WarmT/BLDC-controller/README.md

# BLDC-controller
BLDC controller based on STSPIN32F0

Finished PCBs:
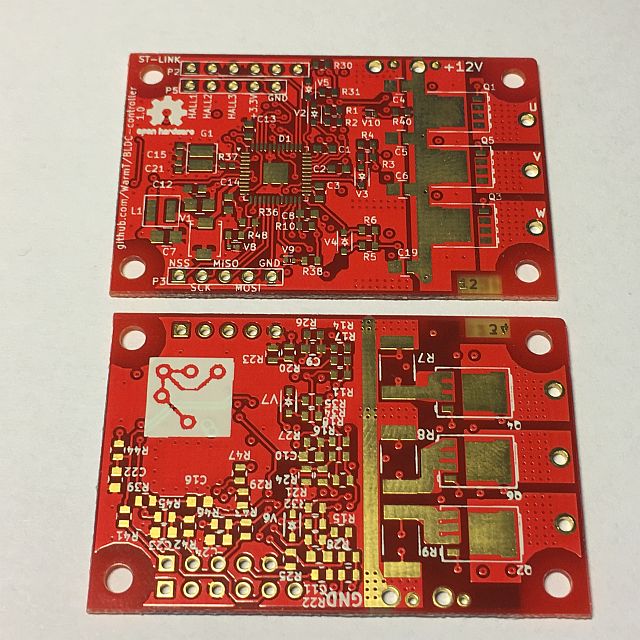
[picture p1: BLDC_controller_PCBs.jpg]
Top
