WarmT/BLDC-controller/PCB_bottom.png

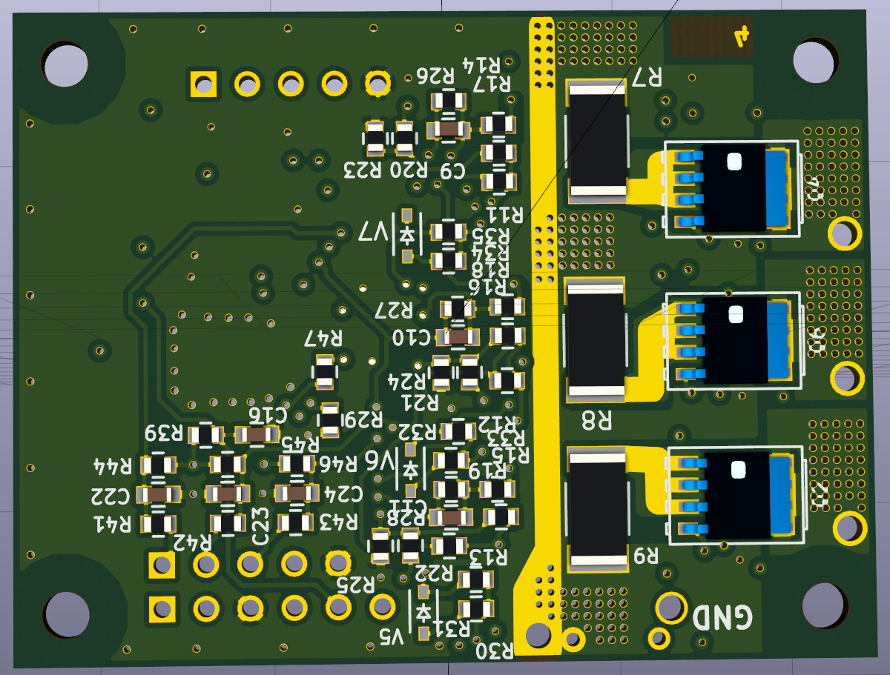
PCB_bottom.png
