WarmT/BLDC-controller/PCB_top.png

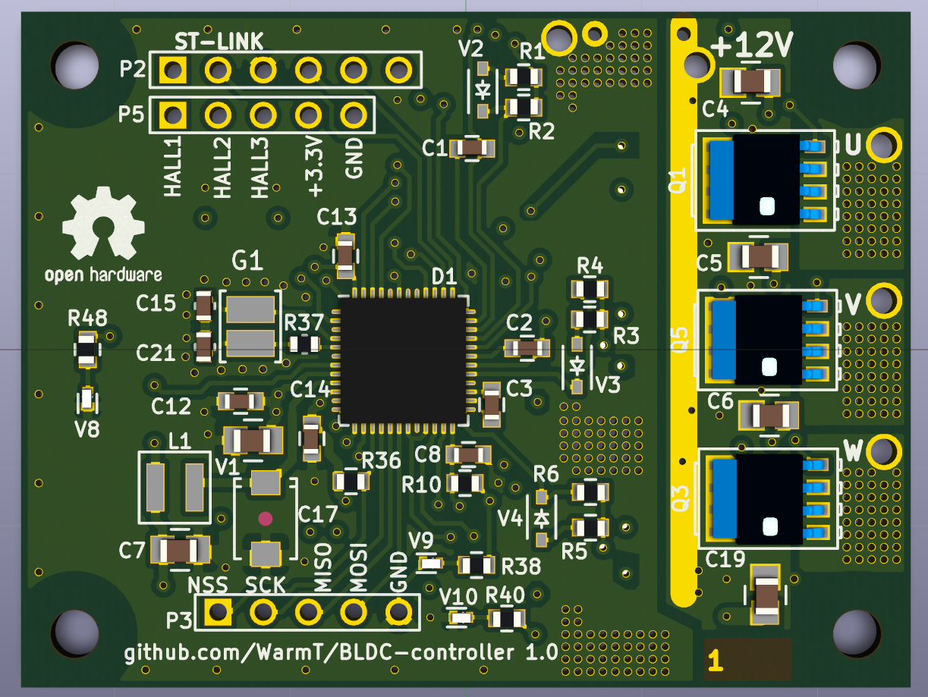
PCB_top.png
