WarmT/BLDC-controller/BLDC_controller.pdf

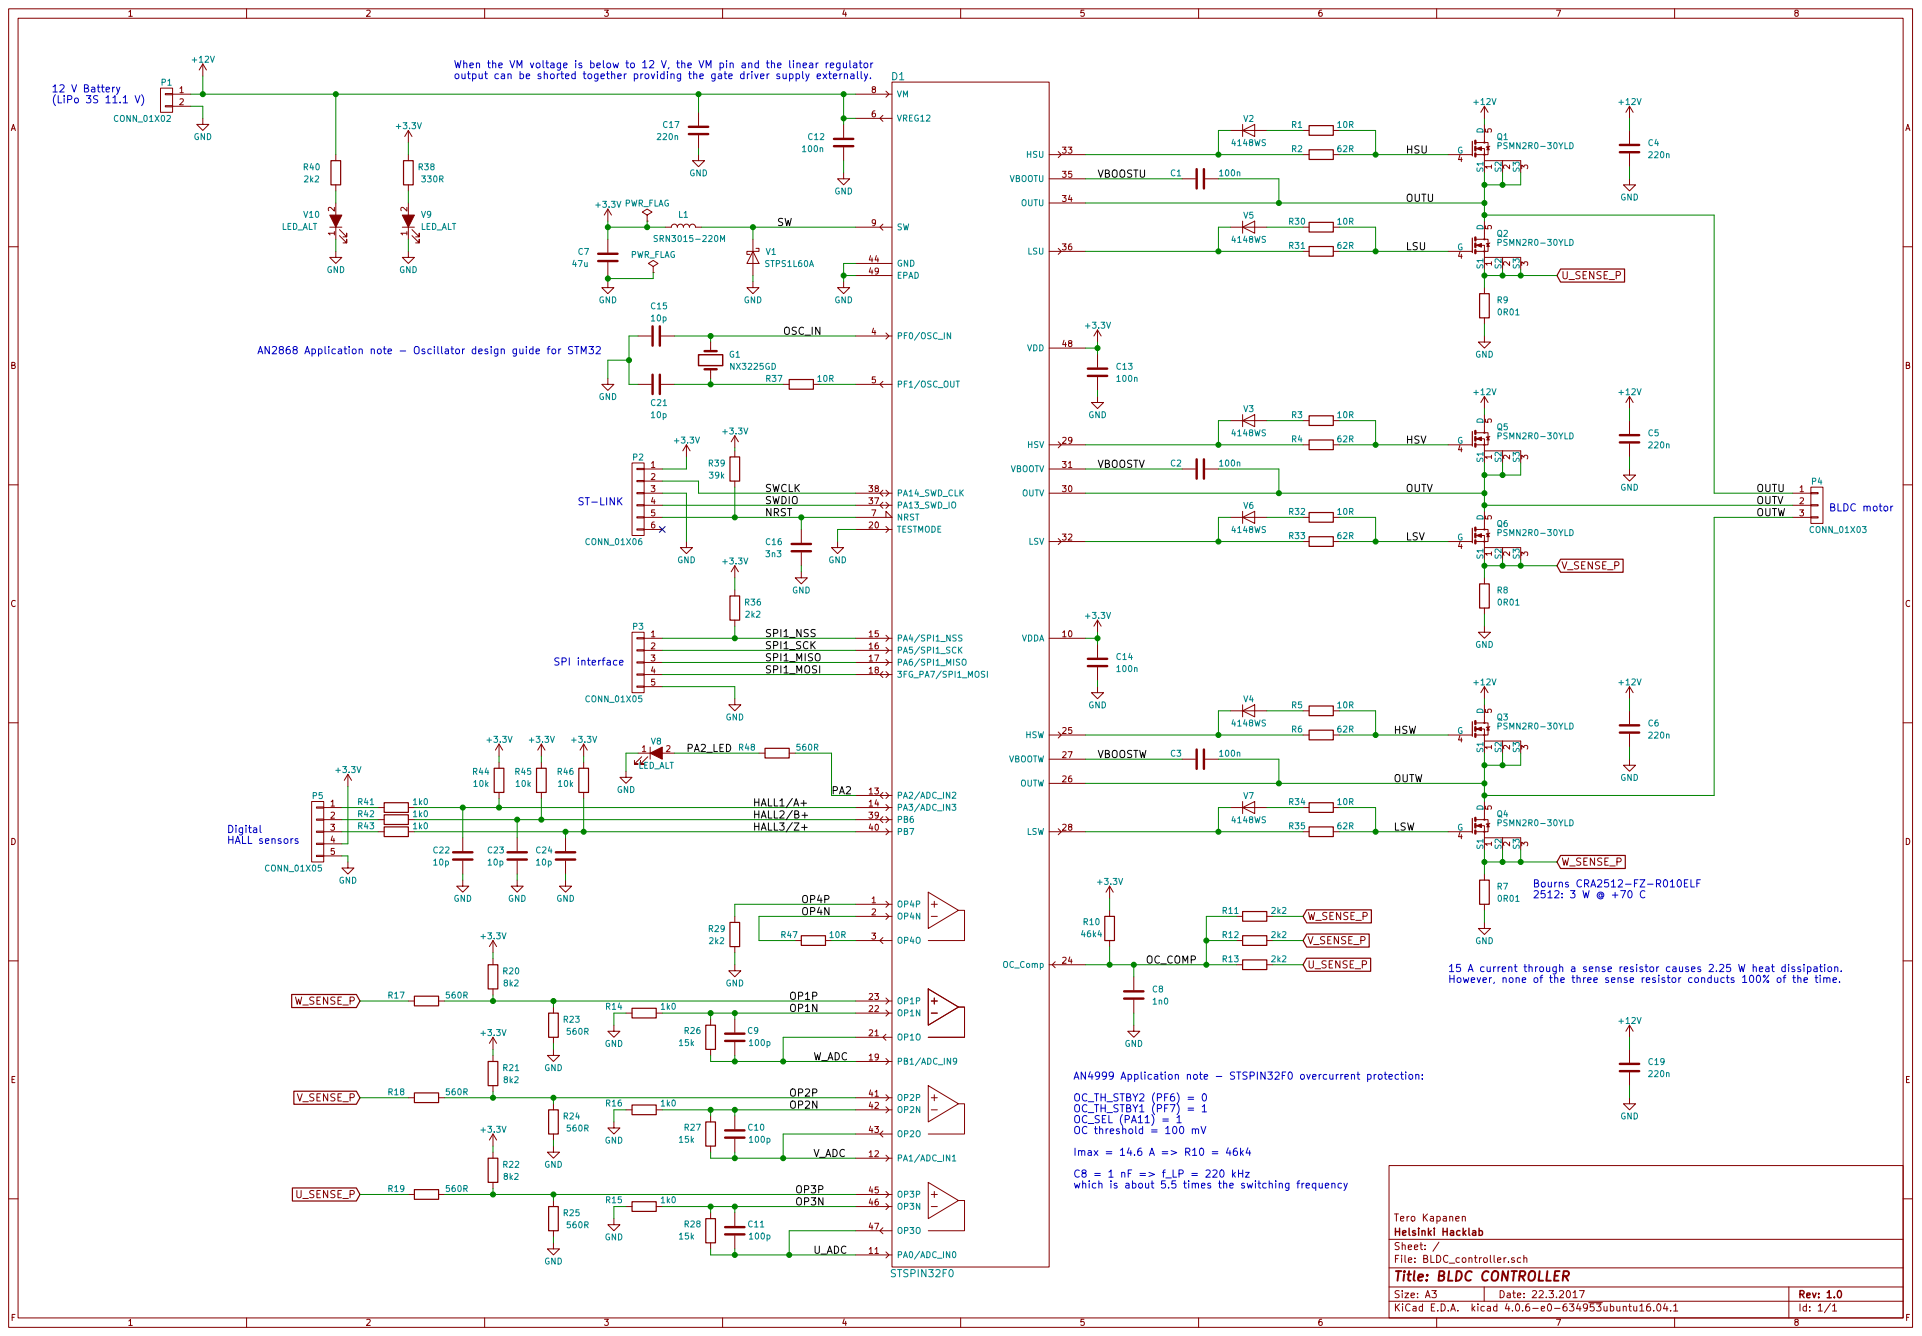
[picture p4: page 1]

PWR_FLAG When the VM voltage is below to 12 V, the VM pin and the linear regulator
output can be shorted together providing the gate driver supply externally.

PF0/OSC_IN 4 PF1/OSC_OUT 5 VREG12 6 NRST 7

AN2868 Application note - Oscillator design guide for STM32

4 | SWDIO
5 | NRST

2 SPI1_SCK
3 SPI1_MISO
4 | 3FG_PA7/SPI1_MOSI 18

15 A current through a sense resistor causes 2.25 W heat dissipation.
However, none of the three sense resistor conducts 100% of the time.

which is about 5.5 times the switching frequency

File: BLDC_controller.sch Sheet: / Helsinki Hacklab

Id: 1/1 Title: BLDC CONTROLLER
