WarmT/BLDC-controller/BLDC_controller.sch

## KiCad design BLDC_controller.sch (2017-03-22)

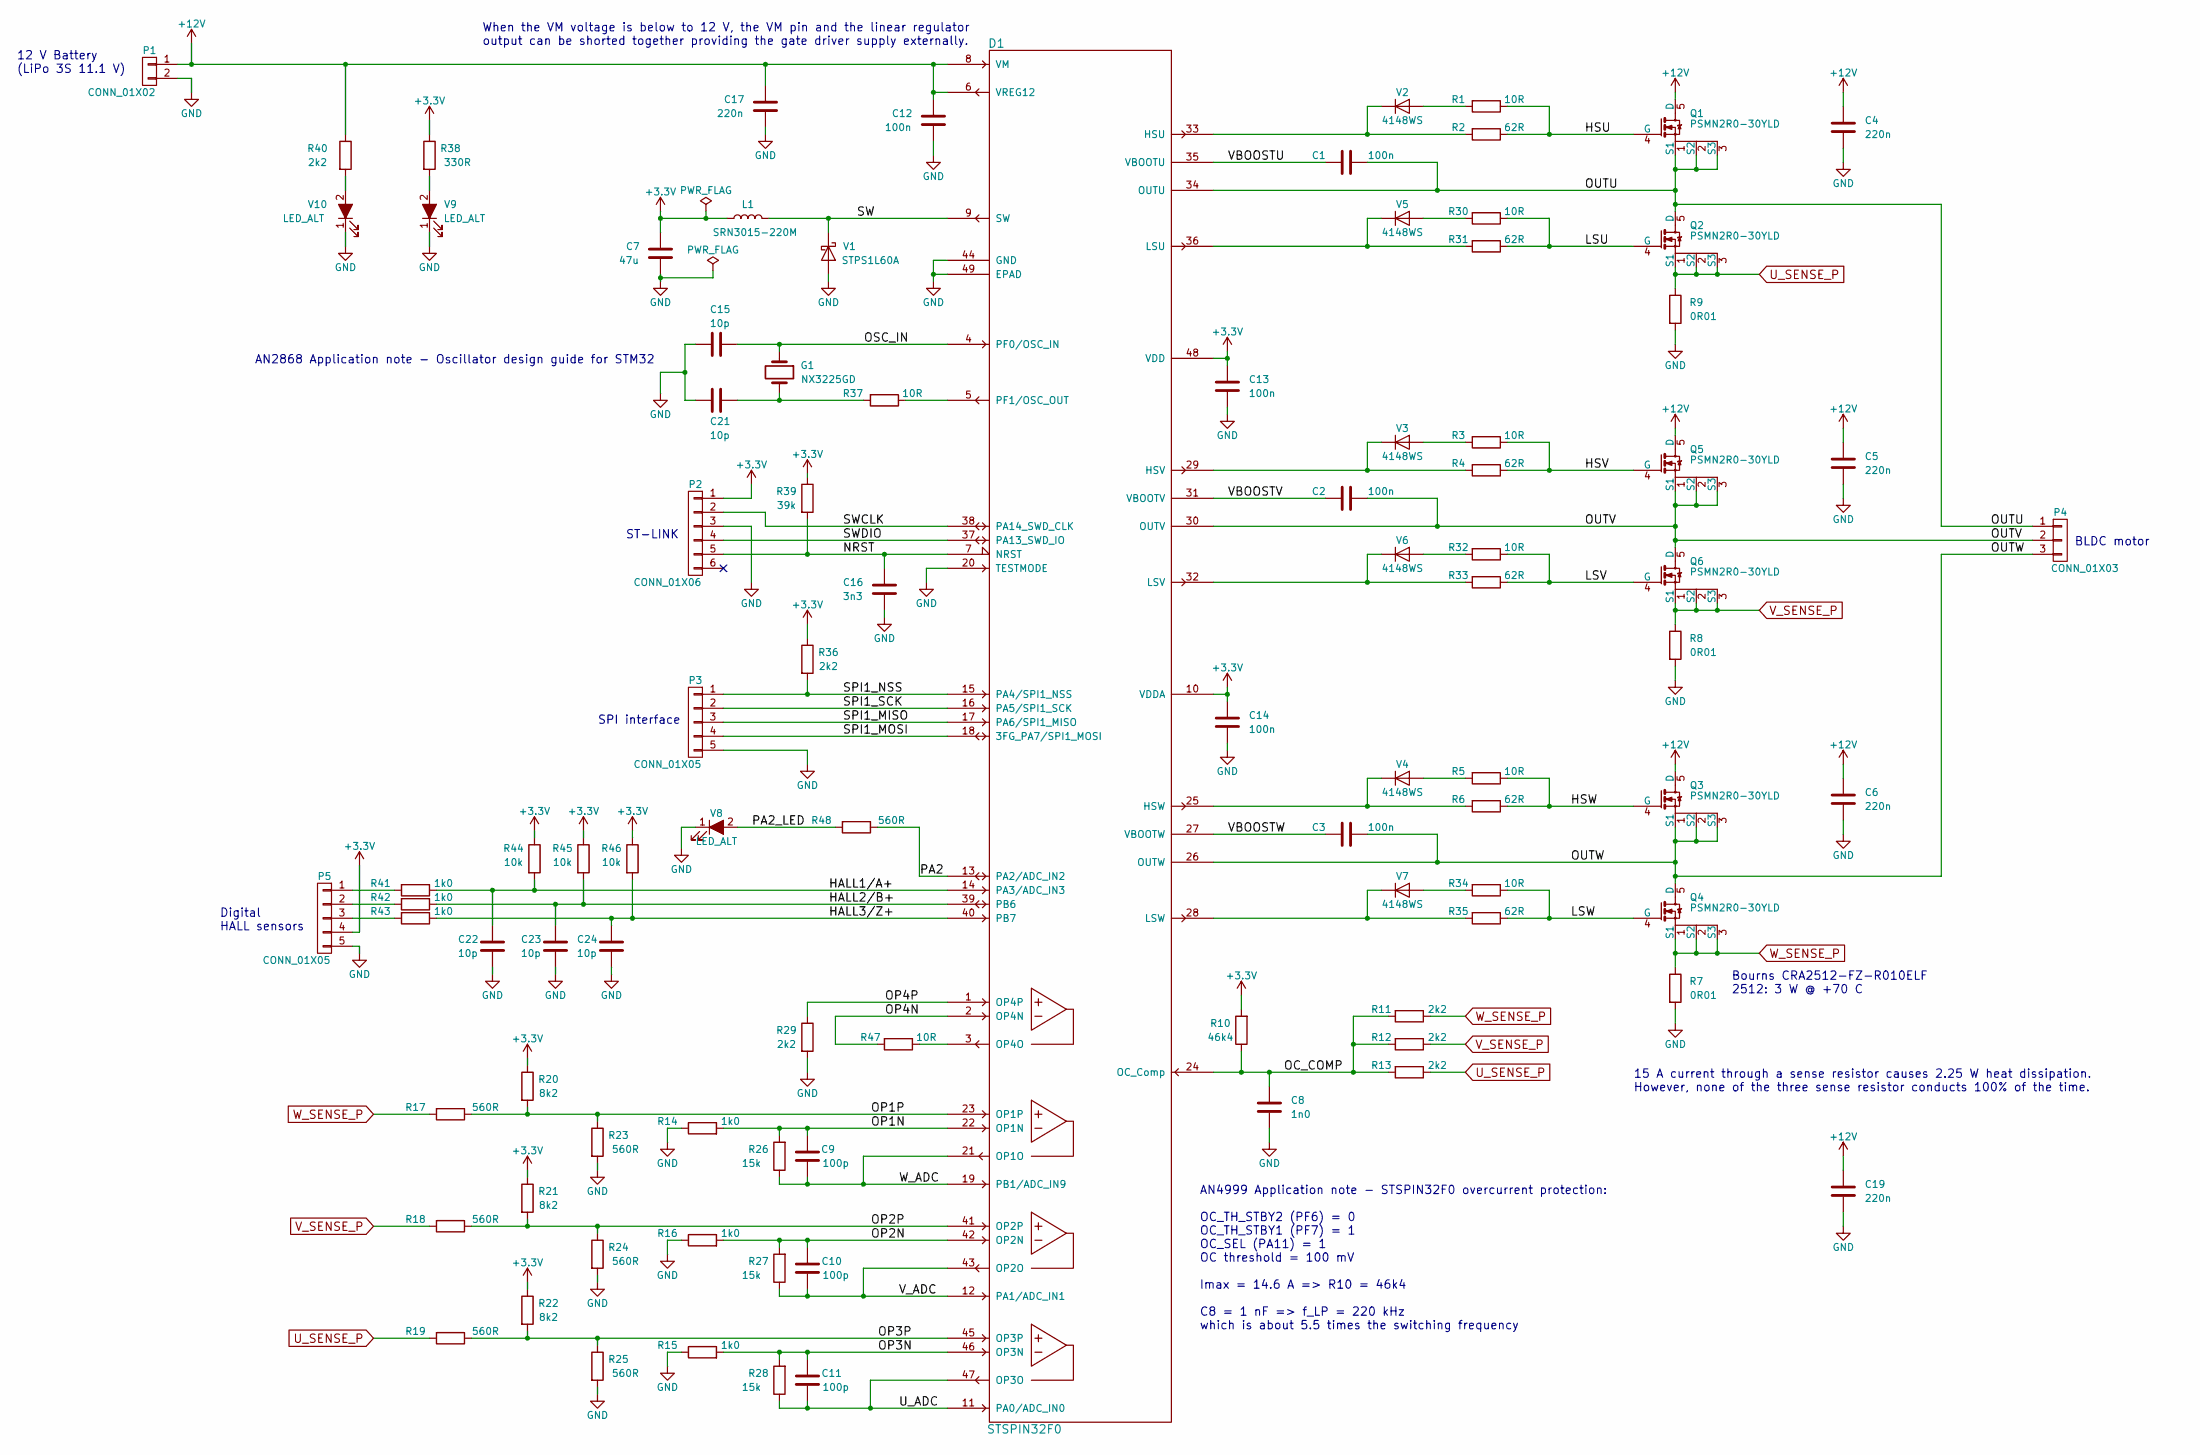
[picture p5: schematic BLDC_controller.sch]

Parts:
C1, C2, C3, C12, C13, C14: 100n; C_0603
C4, C5, C6, C17, C19: 220n; C_0805
C7: 47u; C_0805
C8: 1n0; C_0603
C9, C10, C11: 100p; C_0603
C15, C21: 10p; C_0402
C16: 3n3; C_0603
C22, C23, C24: 10p; C_0603
D1: STSPIN32F0; QFN-48-1EP_7x7mm_Pitch0.5mm
G1: NX3225GD; Crystal_3225
L1: SRN3015-220M; BOURNS-SRN3015
P1: CONN_01X02
P2: CONN_01X06; PINHEAD1-6
P3, P5: CONN_01X05; PINHEAD1-5
P4: CONN_01X03
Q1, Q2, Q3, Q4, Q5, Q6: PSMN2R0-30YLD; SOT-669_LFPAK56
R1, R3, R5, R30, R32, R34, R47: 10R; R_0603
R2, R4, R6, R31, R33, R35: 62R; R_0603
R7, R8, R9: 0R01; R_2512
R10: 46k4; R_0603
R11, R12, R13, R29, R36, R40: 2k2; R_0603
R14, R15, R16, R41, R42, R43: 1k0; R_0603
R17, R18, R19, R23, R24, R25, R48: 560R; R_0603
R20, R21, R22: 8k2; R_0603
R26, R27, R28: 15k; R_0603
R37: 10R; R_0402_MOST
R38: 330R; R_0603
R39: 39k; R_0603
R44, R45, R46: 10k; R_0603
V1: STPS1L60A; SMA
V2, V3, V4, V5, V6, V7: 4148WS; SOD-323
V8, V9, V10: LED_ALT; LED_0402

Connections:
+3.3V: C7.1, C13.1, C14.1, D1.10 (VDDA), D1.48 (VDD), L1.1, P2.1, P5.4, R10.2, R20.1, R21.1, R22.1, R36.1, R38.1, R39.1, R44.1, R45.1, R46.1
+12V: C4.1, C5.1, C6.1, C12.1, C17.1, C19.1, D1.6 (VREG12), D1.8 (VM), P1.1, Q1.5 (D), Q3.5 (D), Q5.5 (D), R40.1
GND: C4.2, C5.2, C6.2, C7.2, C8.2, C12.2, C13.2, C14.2, C15.2, C16.2, C17.2, C19.2, C21.2, C22.2, C23.2, C24.2, D1.20 (TESTMODE), D1.44 (GND), D1.49 (EPAD), P1.2, P2.3, P3.5, P5.5, R7.2, R8.2, R9.2, R14.1, R15.1, R16.1, R23.2, R24.2, R25.2, R29.2, V1.2 (A), V8.1 (K), V9.1 (K), V10.1 (K)
HALL1/A+: C22.1, D1.14 (PA3/ADC_IN3), R41.1, R44.2
HALL2/B+: C23.1, D1.39 (PB6), R42.1, R45.2
HALL3/Z+: C24.1, D1.40 (PB7), R43.1, R46.2
HSU: Q1.4 (G), R1.1, R2.1
HSV: Q5.4 (G), R3.1, R4.1
HSW: Q3.4 (G), R5.1, R6.1
LSU: Q2.4 (G), R30.1, R31.1
LSV: Q6.4 (G), R32.1, R33.1
LSW: Q4.4 (G), R34.1, R35.1
NRST: C16.1, D1.7 (NRST), P2.5, R39.2
unnamed: C21.1, G1.2, R37.2
unnamed: D1.3 (OP4O), R47.1
unnamed: D1.5 (PF1/OSC_OUT), R37.1
unnamed: D1.25 (HSW), R6.2, V4.1 (K)
unnamed: D1.28 (LSW), R35.2, V7.1 (K)
unnamed: D1.29 (HSV), R4.2, V3.1 (K)
unnamed: D1.32 (LSV), R33.2, V6.1 (K)
unnamed: D1.33 (HSU), R2.2, V2.1 (K)
unnamed: D1.36 (LSU), R31.2, V5.1 (K)
unnamed: P5.1, R41.2
unnamed: P5.2, R42.2
unnamed: P5.3, R43.2
unnamed: R1.2, V2.2 (A)
unnamed: R3.2, V3.2 (A)
unnamed: R5.2, V4.2 (A)
unnamed: R30.2, V5.2 (A)
unnamed: R32.2, V6.2 (A)
unnamed: R34.2, V7.2 (A)
unnamed: R38.2, V9.2 (A)
unnamed: R40.2, V10.2 (A)
OC_COMP: C8.1, D1.24 (OC_Comp), R10.1, R11.2, R12.2, R13.2
OP1N: C9.2, D1.22 (OP1N), R14.2, R26.2
OP1P: D1.23 (OP1P), R17.1, R20.2, R23.1
OP2N: C10.2, D1.42 (OP2N), R16.2, R27.2
OP2P: D1.41 (OP2P), R18.1, R21.2, R24.1
OP3N: C11.2, D1.46 (OP3N), R15.2, R28.2
OP3P: D1.45 (OP3P), R19.1, R22.2, R25.1
OP4N: D1.2 (OP4N), R47.2
OP4P: D1.1 (OP4P), R29.1
OSC_IN: C15.1, D1.4 (PF0/OSC_IN), G1.1
OUTU: C1.1, D1.34 (OUTU), P4.1, Q1.1 (S1), Q1.2 (S2), Q1.3 (S3), Q2.5 (D)
OUTV: C2.1, D1.30 (OUTV), P4.2, Q5.1 (S1), Q5.2 (S2), Q5.3 (S3), Q6.5 (D)
OUTW: C3.1, D1.26 (OUTW), P4.3, Q3.1 (S1), Q3.2 (S2), Q3.3 (S3), Q4.5 (D)
PA2: D1.13 (PA2/ADC_IN2), R48.1
PA2_LED: R48.2, V8.2 (A)
SPI1_MISO: D1.17 (PA6/SPI1_MISO), P3.3
SPI1_MOSI: D1.18 (3FG_PA7/SPI1_MOSI), P3.4
SPI1_NSS: D1.15 (PA4/SPI1_NSS), P3.1, R36.2
SPI1_SCK: D1.16 (PA5/SPI1_SCK), P3.2
SW: D1.9 (SW), L1.2, V1.1 (K)
SWCLK: D1.38 (PA14_SWD_CLK), P2.2
SWDIO: D1.37 (PA13_SWD_IO), P2.4
U_ADC: C11.1, D1.11 (PA0/ADC_IN0), D1.47 (OP3O), R28.1
U_SENSE_P: Q2.1 (S1), Q2.2 (S2), Q2.3 (S3), R9.1, R13.1, R19.2
VBOOSTU: C1.2, D1.35 (VBOOTU)
VBOOSTV: C2.2, D1.31 (VBOOTV)
VBOOSTW: C3.2, D1.27 (VBOOTW)
V_ADC: C10.1, D1.12 (PA1/ADC_IN1), D1.43 (OP2O), R27.1
V_SENSE_P: Q6.1 (S1), Q6.2 (S2), Q6.3 (S3), R8.1, R12.1, R18.2
W_ADC: C9.1, D1.19 (PB1/ADC_IN9), D1.21 (OP1O), R26.1
W_SENSE_P: Q4.1 (S1), Q4.2 (S2), Q4.3 (S3), R7.1, R11.1, R17.2

Notes on the sheet:
ST-LINK
Digital HALL sensors
SPI interface
12 V Battery (LiPo 3S 11.1 V)
BLDC motor
Bourns CRA2512-FZ-R010ELF 2512: 3 W @ +70 C
AN4999 Application note - STSPIN32F0 overcurrent protection: OC_TH_STBY2 (PF6) = 0 OC_TH_STBY1 (PF7) = 1 OC_SEL (PA11) = 1 OC threshold = 100 mV Imax = 14.6 A => R10 = 46k4 C8 = 1 nF => f_LP = 220 kHz which is about 5.5 times the switching frequency
15 A current through a sense resistor causes 2.25 W heat dissipation. However, none of the three sense resistor conducts 100% of the time.
AN2868 Application note - Oscillator design guide for STM32
When the VM voltage is below to 12 V, the VM pin and the linear regulator output can be shorted together providing the gate driver supply externally.
