WarmT/BLDC-controller/(threads)

Thread 1 (2017-08-16):

Firmware source code

mkramar, 2017-08-16:
Hi guys, would you mind sharing source code for the project?
I'm building controller based on the same STSPIN32F0 chip and I'm having difficulties initializing timers.
Can't seem to find any examples :(

WarmT, 2017-08-16:
I have to ask from my friend who is writing source code for this project. I have only designed the boards. This project have been in a summer pause and we should continue working on it soon again. :)

Easiest way to make it work is to use the serial port instead of SPI and use STSW-SPIN3201:
http://www.st.com/content/st_com/en/products/embedded-software/motor-control-ic-software/stsw-spin3201.html

This board does not support direct binary creation using STSW-SPIN3201 but for that purpose I have started another project:
https://github.com/WarmT/BLDC-CTRL-UART

Hopefully I get a couple of days where I have no other urgent issues to attend so that I could finish the layout...

mkramar, 2017-08-17:
Thanks for your reply, Tero! This is not UART I'm after (yet), I have difficulties running the timer in 6-pwm mode. There must be something stupid I'm missing but I cannot find any project to compare to. That is why I asked about the source code. If you could email it it would be much appreciated.

Good luck with new layout, but don't push too hard during summer :) Its winter here in Australia :)

Thread 2 (2017-11-01):

Hardware question

ideaRunner, 2017-11-01:
Hi WarmT,
Thank you for your sharing hardware design.
It really helps me a lot.

But there is something I don't understand.
There is a resistance between HSU and G of NMOS,like R2,R31,R4 and so on.
There also have a resistance with diode between HSU and G of NMOS,like R1, V2

I searched in the official documentation of STSPIN32F0 and also the hardware design of STEVAL-SPIN3201. They deal with it same as you.

But I don't understand the purpose even if i have looked some other BLDC hardware design ( TI ).
Can you give me little tips?
How to calculate the value of resistance?
Why we need to put some resistance and diode like that?
What will happen if not?

Thank you again!

WarmT, 2017-11-02:
Those resistors with diodes in series are there to make sure that the FETs turns off faster than the other FETs turns on. This gives safety margin and ensures that both FETs does not conduct at the same time even if they are switched on the same clock edge.

ideaRunner, 2017-11-06:
Thank you!
You are very experienced !
