WarmT/BLDC-controller/(commit log)

2017-02-13 add HALL header
    [BLDC_controller.sch]
2017-02-14 minor change
    [BLDC_controller.sch]
2017-02-15 add schematic pdf
2017-02-16 minor corrections
    [BLDC_controller.sch]
2017-02-18 add SPI interface
    [BLDC_controller.sch]
2017-02-19 cosmetic changes
    [BLDC_controller.sch]
2017-02-19 overcurrent protection documented
    [BLDC_controller.sch]
2017-02-19 most footprints selected
    [BLDC_controller.kicad_pcb, BLDC_controller.sch]
2017-02-22 parts in place
    [BLDC_controller.kicad_pcb, BLDC_controller.sch]
2017-02-26 mostly routed
    [BLDC_controller.kicad_pcb, BLDC_controller.sch]
2017-02-28 keepouts added under sense resistors
    [BLDC_controller.kicad_pcb, BLDC_controller.sch]
2017-03-05 Layout ready for 1st review
    [BLDC_controller-B.Cu.gbr, BLDC_controller-B.Mask.gbr, BLDC_controller-B.SilkS.gbr, BLDC_controller-F.Cu.gbr, BLDC_controller-F.Mask.gbr, BLDC_controller-F.SilkS.gbr, BLDC_controller-In1.Cu.gbr, BLDC_controller-In2.Cu.gbr]
2017-03-06 change thermal vias smaller
    [BLDC_controller-B.Cu.gbr, BLDC_controller-B.Mask.gbr, BLDC_controller-B.SilkS.gbr, BLDC_controller-F.Cu.gbr, BLDC_controller-F.Mask.gbr, BLDC_controller-F.SilkS.gbr, BLDC_controller-In1.Cu.gbr, BLDC_controller-In2.Cu.gbr]
2017-03-07 firts review comments updated
    [BLDC_controller-B.Cu.gbr, BLDC_controller-B.Paste.gbr, BLDC_controller-B.SilkS.gbr, BLDC_controller-F.Cu.gbr, BLDC_controller-F.Mask.gbr, BLDC_controller-F.Paste.gbr, BLDC_controller-F.SilkS.gbr, BLDC_controller-In1.Cu.gbr]
2017-03-10 minor improvements
    [BLDC_controller-B.Cu.GBL, BLDC_controller-B.Mask.GBS, BLDC_controller-B.Paste.GBP, BLDC_controller-B.SilkS.GBO, BLDC_controller-Eco2.User.gbr, BLDC_controller-Edge.Cuts.GM1, BLDC_controller-F.Cu.GTL, BLDC_controller-F.Mask.GTS]
2017-03-11 self-intersecting polygons
    [BLDC_controller-B.Cu.gbl, BLDC_controller-B.Mask.gbs, BLDC_controller-B.Paste.gbp, BLDC_controller-B.SilkS.gbo, BLDC_controller-Eco2.User.gbr, BLDC_controller-Edge.Cuts.gm1, BLDC_controller-F.Cu.GTL, BLDC_controller-F.Cu.gtl]
2017-03-12 thermal reliefs -> solid
    [BLDC_controller.kicad_pcb]
2017-03-14 ready for 2nd review
    [BLDC_controller-B.Cu.gbl, BLDC_controller-B.Mask.gbs, BLDC_controller-B.Paste.gbp, BLDC_controller-B.SilkS.gbo, BLDC_controller-Eco2.User.gbr, BLDC_controller-Edge.Cuts.gm1, BLDC_controller-F.Cu.gtl, BLDC_controller-F.Mask.gts]
2017-03-19 board size changed to 49x32 mm
    [BLDC_controller-B.Cu.gbl, BLDC_controller-B.Mask.gbs, BLDC_controller-B.Paste.gbp, BLDC_controller-B.SilkS.gbo, BLDC_controller-Eco2.User.gbr, BLDC_controller-Edge.Cuts.gm1, BLDC_controller-F.Cu.gtl, BLDC_controller-F.Mask.gts]
2017-03-19 panelize design
    [BLDC_controller-B.Cu.gbl, BLDC_controller-B.Mask.gbs, BLDC_controller-B.Paste.gbp, BLDC_controller-B.SilkS.gbo, BLDC_controller-Eco2.User.gbr, BLDC_controller-Edge.Cuts.gm1, BLDC_controller-F.Cu.gtl, BLDC_controller-F.Mask.gts]
2017-03-20 QFN package improved
    [BLDC_controller-B.Cu.gbl, BLDC_controller-B.Mask.gbs, BLDC_controller-B.Paste.gbp, BLDC_controller-B.SilkS.gbo, BLDC_controller-Eco2.User.gbr, BLDC_controller-Edge.Cuts.gm1, BLDC_controller-F.Cu.gtl, BLDC_controller-F.Mask.gts]
2017-03-20 improved QFN panelized
    [BLDC_controller-B.Cu.gbl, BLDC_controller-B.Mask.gbs, BLDC_controller-B.Paste.gbp, BLDC_controller-B.SilkS.gbo, BLDC_controller-Eco2.User.gbr, BLDC_controller-Edge.Cuts.gm1, BLDC_controller-F.Cu.gtl, BLDC_controller-F.Mask.gts]
2017-03-22 Add Helsinki Hacklab logo
    [BLDC_controller-B.Cu.gbl, BLDC_controller-B.Mask.gbs, BLDC_controller-B.Paste.gbp, BLDC_controller-B.SilkS.gbo, BLDC_controller-Eco2.User.gbr, BLDC_controller-Edge.Cuts.gm1, BLDC_controller-F.Cu.gtl, BLDC_controller-F.Mask.gts]
2017-04-16 add BoM
    [BLDC_controller.csv]
